Magizhan-RS/Keplarian-Extraction-of-Eccentricity-of-Earth-s-Orbit-Alias-Project-C.H.I.T.R.A.N/README.md

# Keplarian-Extraction-of-Eccentricity-of-Earth-s-Orbit-Alias-Project-C.H.I.T.R.A.N
This project is a combination of classical physics, advanced projection of time and architecture keeping the planetary motion in mind.   
Enjoy Reading!! 
If possible, please support the project by building the prototype and provide data to help the project prove its potential.  
Regards  Magizhan R S
